megnbenson/flowers/FlowerDesign.stl

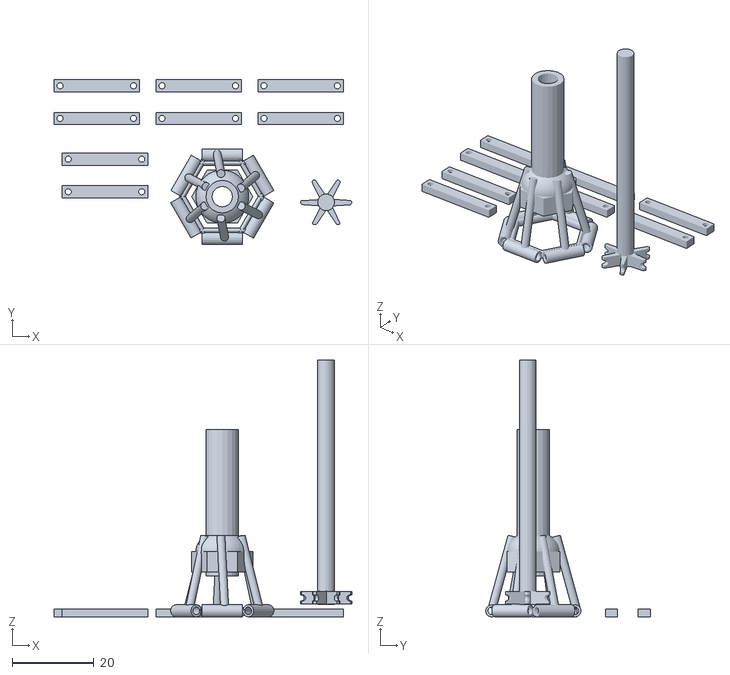
[picture p1: CAD file, 2020-06-19]
FlowerDesign.stl
73.1 x 40.4 x 63.0
