megnbenson/flowers/cogs and teeth.stl

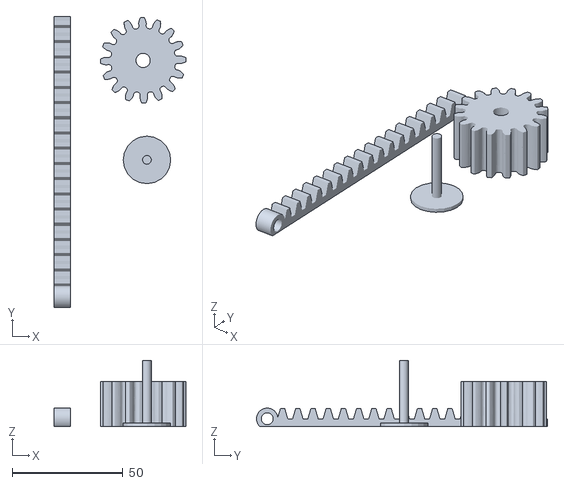
[picture p2: CAD file, 2020-06-19]
cogs and teeth.stl
59.5 x 131.4 x 29.9
