megnbenson/flowers/Ever-Blooming-Mechanical-TulipInstructablesStartingPoint.pdf

instructables

Ever Blooming Mechanical Tulip (http://www.instructables.com/id/Ever-Blooming-Mechanical-Tulip/)

by jiripraus (http://www.instructables.com/member/jiripraus/)

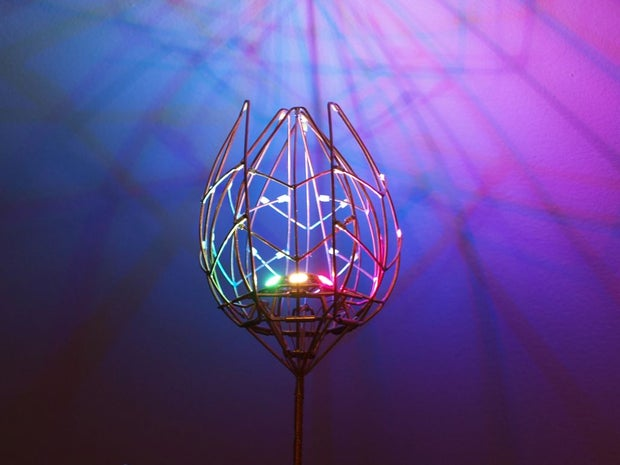
[picture p3: figure]

### Step 1: Watch the Video!

Everlasting

ower for your everlasting love. A perfect not-only Valentine's day gift to your loved one. This mechanical tulip will bloom into any color possible with just gentle touch of your hand. Its six petals will slowly open and light up. When petals are closed they create incredible ambient light with leaf patterns.

https://www.youtube.com/embed/NvRck1Xt7Oc?feature=oembed

Ever Blooming Mechanical Tulip: Page 1

### Step 2: How Does It Work?

I did not record the original tulip on the camera. But I've designed a bit simpli/ed version and shoot a nice video of making these. The concept is the same. You will get an idea of how it works and how it is built.

href="https://www.youtube.com/watch?v=5KxzI7kZFfo">Watch!

Join the community (https://www.facebook.com/groups/210332863382496/) to get in touch with fellow

makers to share ideas, experience and improve the design!

Visit everblooming

ower.com (https://everbloomingflower.com) if you want to have one!

https://www.youtube.com/watch?v=5KxzI7kZFfo

But before I will tell you how to create this beauty, let's talk brie

y about how it works. Tulip consists of 6 petals each with 5 SMD white LEDs. Each petal is connected with one of the Arduino output pins. Blossom hides 7 NeoPixel RGB LEDs. From an electrical point of view, the whole

ower is ground and veins in petals are a positive voltage. Petals are opened by a pushrod which is going all the way down the stem to the base. The pushrod is controlled by a movement of a small hobby servo. Small leaf on the side of the stem is connected to TTP223 touch sensor inside the base and creates a capacitive touchpad. The wooden base contains a servo motor, touch IC and Arduino Nano. Let's build one yourself!

Wha t a re yo u go nna ne ed?
1mm brass rod
2mm brass tubing with 1, 2mm hole 0.3mm copper wire with insulation Some wood for pedestal
Arduino Nano
TTP223 touch sensor
Small servo

Wha t yo u ne ed t o know be f o re yo u s t a rt
How to solder brass (great article) (https://davidneat.wordpress.com/2015/05/03/a-quick-guide-to-soldering-brass/amp/) How to build with Arduino
How to use servos
How to use LEDs and NeoPixels

I am not telling you any dimensions of the components and exact shape of the blossom. I think every

ower should
be a unique one.

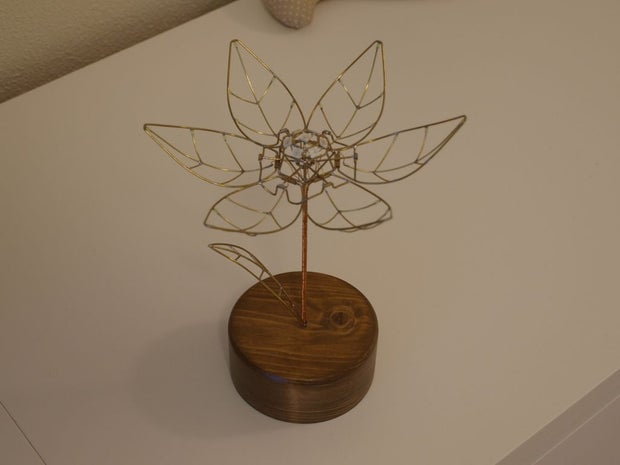
[picture p4: figure]

### Step 3: The Petals (4h)

Let's start with the most satisfying part /rst - petals of the blossom. Note that number in the brackets is a time required to do the step.

The /rst thing you need is a template for the blossom. I created mine from plaster poured into tube mold. When it dried I shaped it into a tulip blossom. You can 3D print it as well but I don't have a 3D printer. The plaster is great because it is easy to machine and a pencil can draw on it. Single petal is 1/4 of the surface of the template so at the end when there are gonna be 6 of them, they will slightly overlap each other creating exact look of a tulip blossom. I draw the petal shape on the surface of the plaster with a pencil. When I was satis/ed with the petal shape I carved it into the plaster with a knife to help me hold rods in place while soldering.

Petal consists of 1mm brass rod going all the way

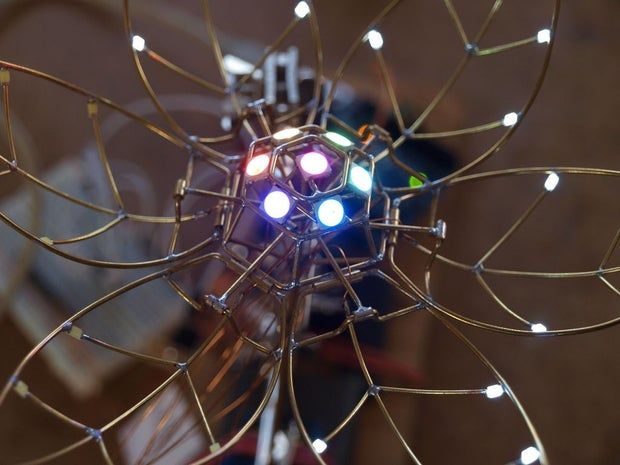
[picture p5: figure]

around the shape. Inside the petal are 5 SMD 1206 white LEDs and a "vein" structure from the very same wire. First, create the circumferential wire, take your time bending it. Cut a small piece of tubing and pass it on the bottom

at part of the wire - this will be the hinge petal will move around. Solder ends of the wire together, make sure you don't /ll the tubing with solder. It needs to move freely. Finish the petal with LEDs and venous structure. Watch me making a single petal. Shame on me, this is the only footage I have from making the

ower.

Now make 5 more of these. All pet als need to be exactly the same. It's really crucial. Otherwise, they would not resemble a nice even tulip shape at the end when closed and may even get stuck.

https://www.youtube.com/embed/GoVWk30cFtE

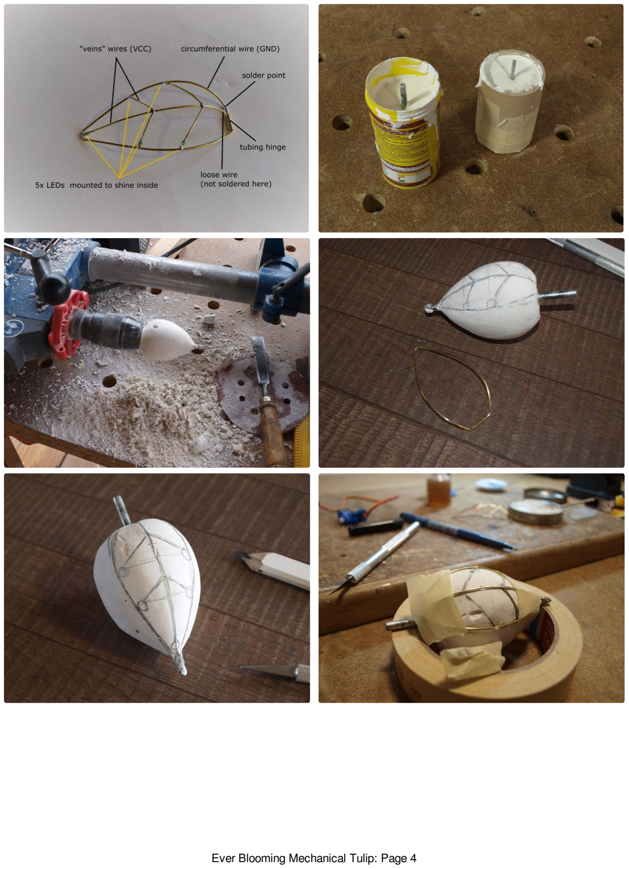
[picture p6: page 4]

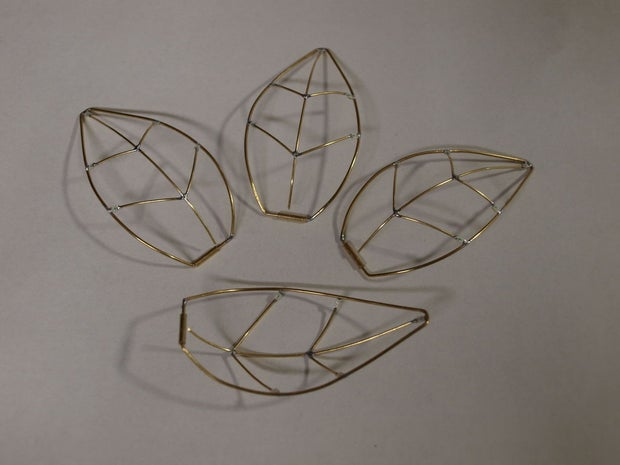
[picture p7: figure]

### Step 4: Blossom (1h)

So far so good? It's time to solder all the petals together. The base of the blossom is hexagonal - 6 petals. Petals are /xed to the hexagon via hinges. The hexagon, however, is slightly irregular. I failed with a regular one. Petals need to overlap each other and if the hexagon is regular they are not allowed to. Three petals are closer to the center (inner petals) and other 3 in slight oKset (outer petals). For that, I created a template and printed it on a paper. The red shape is

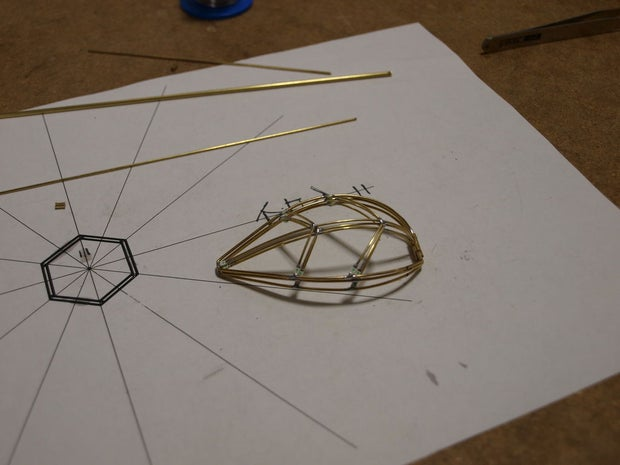
[picture p8: figure]

the /nal irregular hexagon made out of two nested regular hexagons. Solder all the hinges (tubings) to the hexagon. Rays coming out of the center of the template will help you to solder the petals in a correct position. The center of the petal needs to follow the ray line coming out of the center of the hexagon. At the end when you close the petals you will have the /nal shape of the blossom. Nice isn't it?

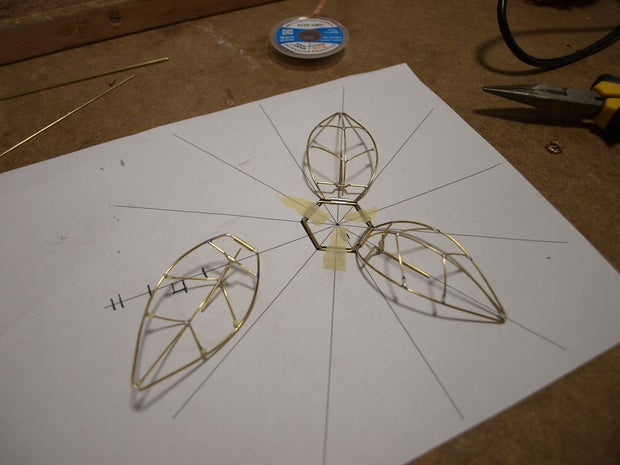
[picture p9: figure]
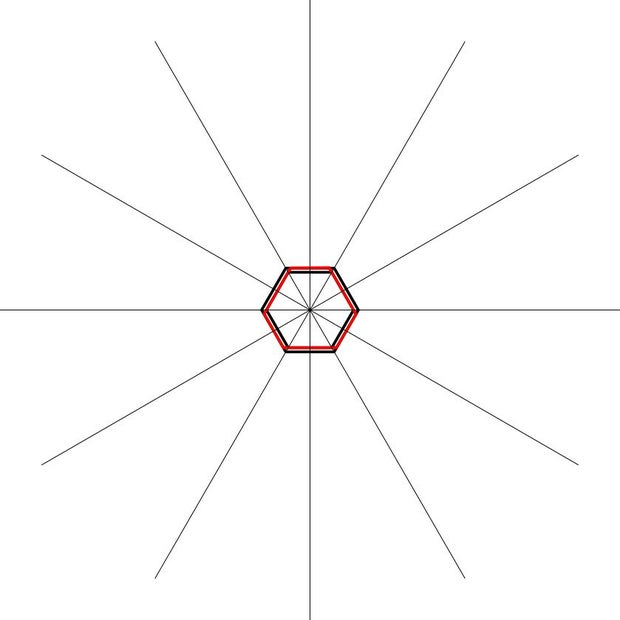
[picture p10: figure]

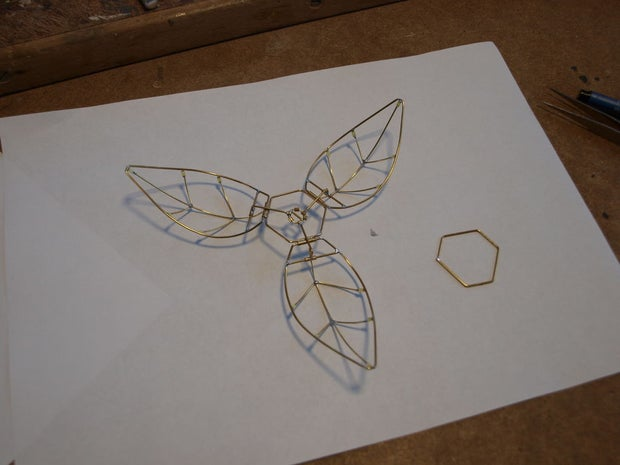
[picture p11: figure]

### Step 5: Creating the Stem and Pushrod (1h)

This is not how I proceed in my making of the

ower. I
/rst /nished the mechanism inside the blossom and then added a stem and pushrod to it. It added a lot of misery into the making. Once I almost wanted to trash it and never look back. Next time I will /rst start with the stem. So you should as well.

Movement of the petals is created by a 1mm brass pushrod freely moving inside a brass tubing. Petals are connected to the pushrod through a really tiny hexagon with small 2mm long hinges on each side -pushrod head. Hexagon is sitting perpendicularly on the pushrod with a help of small bar running through the center of the hexagon. This is watchmaker's job.

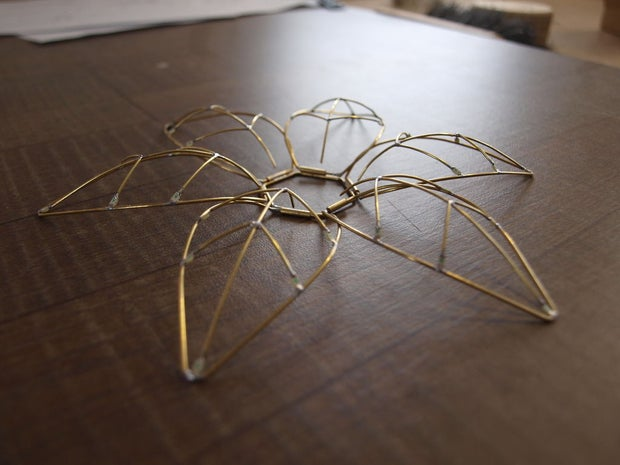
[picture p12: figure]

To create the pushrod head I created the second template. First, bend the wire to form the tiny hexagon. Then cut small 2mm long tubings and pass them on the wire. Solder the wire to /nish the hexagonal shape. Again make sure you do not solder the tubing to the wire. Continue by soldering wire into the center of the hexagon. And /nish the rod by soldering a 1mm wire perpendicular to the center of the pushrod head. Hurray! You have your pushrod.

Build the stem. Cut brass tubing to the desired length. And now the second crucial part. The stem needs to be perfectly perpendicular to the hexagonal base of blossom, needs to be in the exact center of it

and there needs to be enough room for the pushrod head to move down to close the petals. First, I soldered two wires to one end of the stem to create a V-shaped expansion. These will be the 2 out of 6 wires connecting stem to the vertices of hexagonal base.

So

ip the blossom upside down and solder the V-shaped expansion to the 2 opposite vertices of the hexagonal base. Check the shape. If you put a rod inside the stem it needs to come out in the center of the blossom. Take your time here making it perfect. It's really a crucial part. When you are /ne with it, solder 4 more wires between the rest of the hexagon's vertices and the top of the stem. Make sure not to solder the hole inside the tubing!

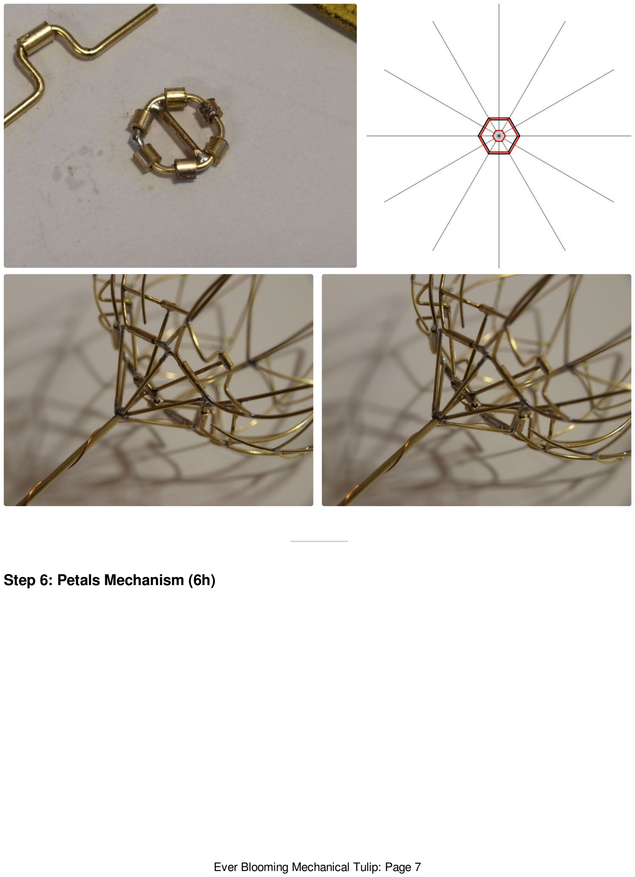
[picture p13: page 7]

### Step 6: Petals Mechanism (6h)

This is the part you gonna regret you ever started making the

ower in the /rst place. I almost throw it into the trash once. But hey, I am not the most patient guy ever. You are gonna nail it! For this part, I've got inspired by steam engines and their rods, pistons, and ywheels.

Make yourself a test stand. Fix the

ower with the
stem in an upward position. Put the pushrod through the stem with its head upward. Solder short tubing perpendicular to the bottom end of the pushrod and create yourself a small connecting rod out of 1mm brass wire to connect servo and the pushrod (see the picture above). You should be able to move with pushrod up and down using a servo. Try it by hooking up your Arduino. Before you can start soldering the connecting rods between petals and pushrod head you need to tune up the servo movement with Arduino. Write your code to move pushrod up and down in a way when in the topmost position the pushrod head end is

ush with blossom hexagonal base. And in the lowest position, it sits on the bottom of the blossom V-shaped base.

Tip: Use Adafruit_TiCoServo (https://github.com/adafruit/Adafruit_TiCoServo) library to control the servo. Itwill allow you later to control NeoPixels atthe same time asthe servo.

Tip: To make your pushrod movementis assoft as possible, use the hole closestto the center of the servo arm. The servo will need to spin longer butwith shorter steps.

Petals are currently missing one crucial part - petal pin. This hinge makes the petals move. The hinge sits on a bar (see image above) which is soldered to each petal parallel to its base. Petal pin needs to be above the surface of the petal in order to allow it to fully open as you can see on the animation. Make yourself one such bar with a hinge from tubing and solder it to the /rst petal. This will need a lot of experimenting with the size of the bar and its distance from the petal base to allow the pushrod to fully open and close the petal. Use trial and error method. Solder the bar to a suitable position and add connecting rod between the pushrod pin and the petal pin. If you have your pushrod in the upper position and your petal in a fully opened position, space between pushrod pin and petal pin is the length of the connecting rod.

Now try to move with pushrod up and down to see what is happening. If it works /ne without any rubbing and petal can be closed and opened you are done (with the /rst petal)! If not, try a diKerent length of connecting rod or diKerent position of the bar. In order to /nish the blossom, duplicate the same bar and connecting rod on each of the 5 remaining petals. The 3 outer petals need to be a little lower when the blossom is opened to allow them to properly overlap the inner petals while closing. In the end, you should be able to close and open the blossom. Don't panic if you failed to do the perfect shape for the /rst try. It only means all the petals are not perfectly the same. It will probably take a lot of /ne-tuning to create a perfect shape - slightly diKerent lengths of connecting rods and positions of bars. Take your time here! A reward is near.

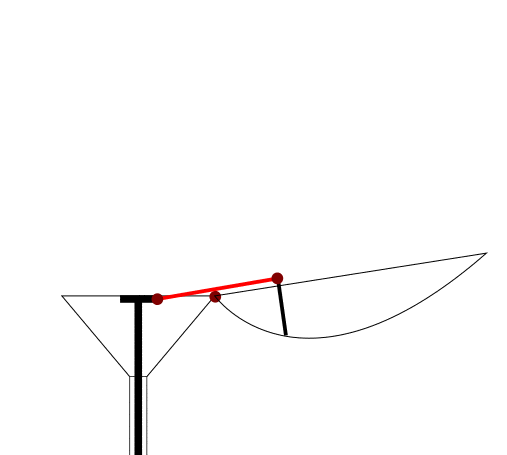
[picture p14: figure]

https://www.youtube.com/embed/_hzQIuPzaBM

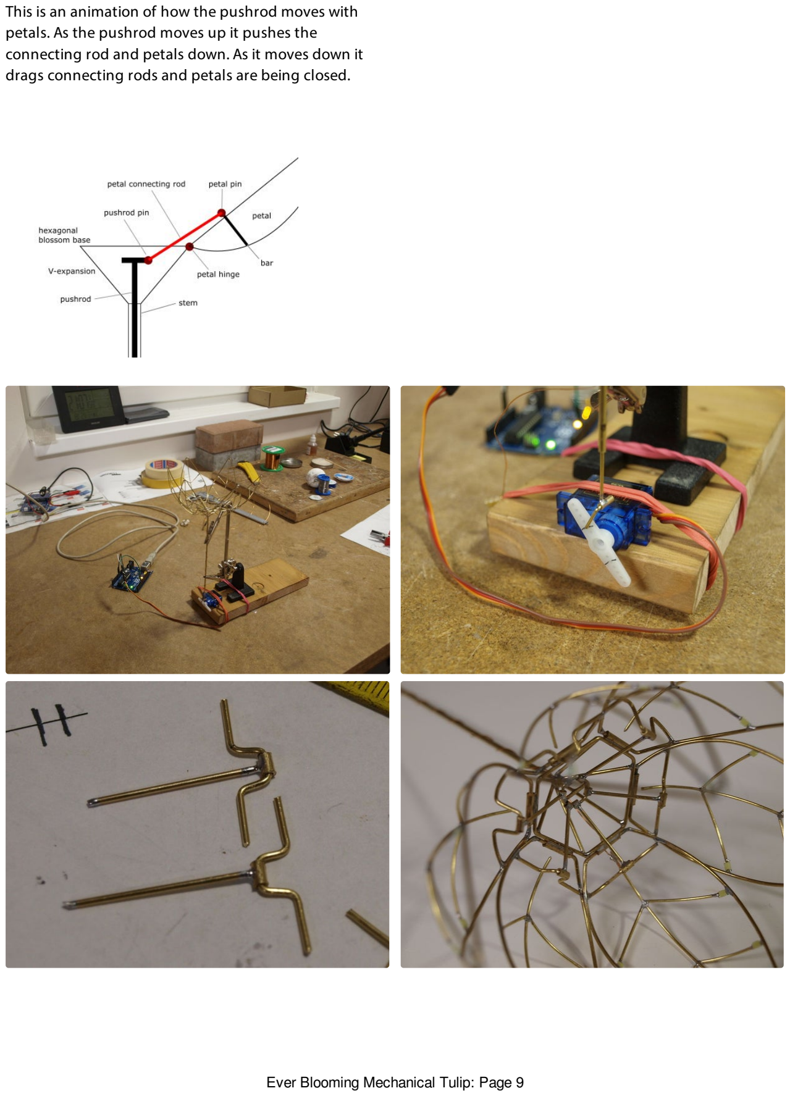
[picture p15: page 9]

This is an animation of how the pushrod moves with petals. As the pushrod moves up it pushes the connecting rod and petals down. As it moves down it drags connecting rods and petals are being closed.

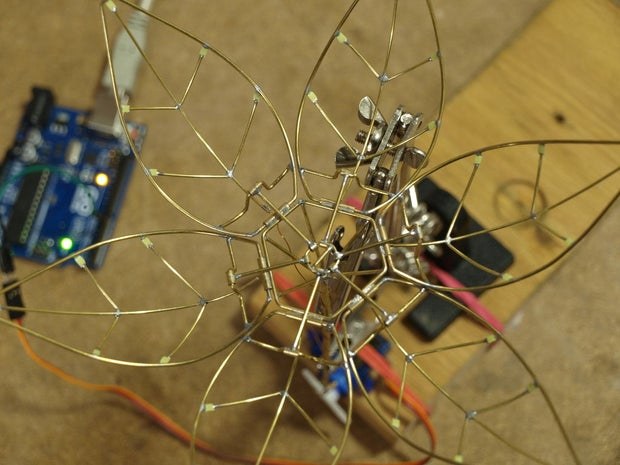
[picture p16: figure]

### Step 7: Rainbow Pistil (1h)

If you made it to this step you are a king and the hardest parts are behind you. Inside the blossom, I put 7 NeoPixels LEDs to shine from inside. These LEDs need only one DATA wire to be controlled and can be daisy chained. I soldered 6 of these between two small hexagons (another template of course). Lower hexagon is a ground wire and the upper one is a positive voltage. Solder appropriate leads of NeoPixels to these hexagon rings. These LEDs are placed under the 45-degree angle to shine into sides. To make it even better place the seventh LED into the center of the upper hexagon. Last but not least connect DATA IN and OUT leads to create a daisy chain.

This structure will need two wires going down to the pedestal - VCC and DATA. The ground is taken from the

ower frame. Solder one thin 0.3 insulated copper wire to the upper ring for VCC and the second one to the /rst LED in the daisy-chain for DATA. These wires will at the end go down to the pedestal. Make them at least 3 times the length of the stem. Ends of these wires need to be released from their transparent insulation prior to soldering. Heat won't destroy it. Use a knife to strip oK the insulation. You can test the LEDs now to make sure they work. Be gentle with these copper wires. If you accidentally strip the insulation anywhere else than ends, you might get a short circuit!

Last brass soldering work is now going to happen! Place the pistil structure to the center of the blossom. Slightly oKset it from the blossom hexagonal base to leave enough room for petals connecting rods. For me, it was 1cm above the blossom hexagon. Connect all the vertices with brass rods to make a solid structure. The

ower is done! Test it now to see if petals can still move freely.

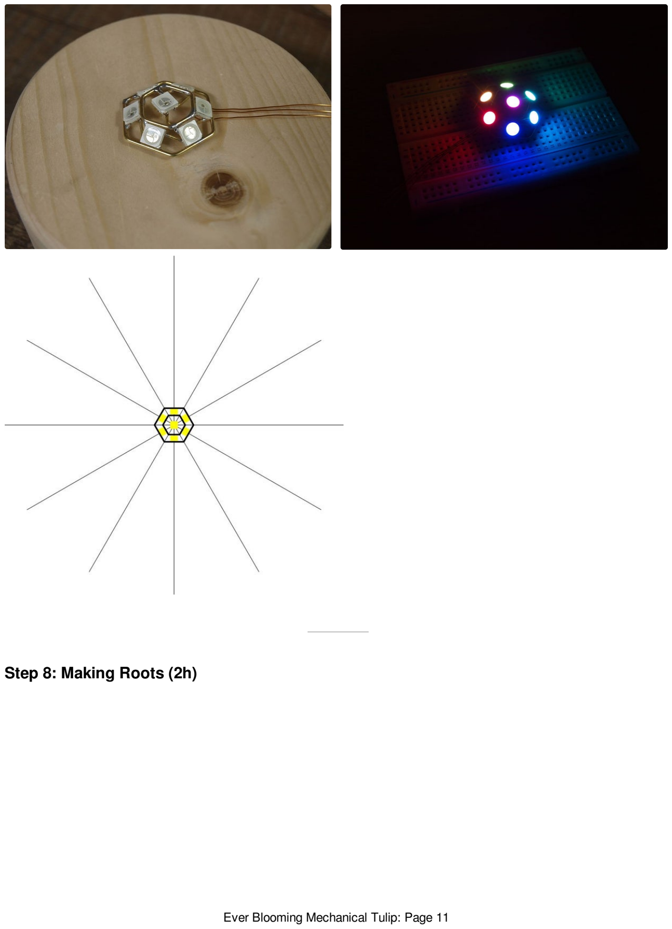
[picture p17: page 11]

### Step 8: Making Roots (2h)

Both petals and NeoPixel LEDs need power wires to shine. The whole

ower sculpture will be a ground but there are 6 petals and 2 wires for NeoPixels that need to be connected to Arduino in the pedestal. For that, thin 0.3mm copper wires with transparent insulations will be wrapped around the stem tubing. Two wires for Neopixels are already done. Solder another 6 to the loose vein wire on each petal near the hinge and pass the wire through the blossom structure down the stem. Make sure you don't bend these wires in sharp angles, it would break soon.

Now gather all the wires near the upper end of the stem tubing and secure them using strapping tape. Don't tighten it too much yet, allow wires to be pulled through it. Now nicely organize all the wires inside the blossom. Make sure petals are free to move and the pushrod is not colliding with the wires as well. Done?

Now tighten the strapping tape.

Wires are now

ying around the stem uncontrollably. You need to patiently and slowly wrap them down the stem. Tightly and evenly. It took me at least an hour to /nish this step. When you are at the end of the stem, place another strapping tape to secure the wires there and use clear superglue to /x them in the place. Make sure not to seal the tubing with the pushrod!

Last wire missing is a ground. Solder another copper wire to the bottom end of the stem. You should end up with 9 wires coming out of the

ower. It'd wise
now to connect all the wires to Arduino and test whether there is no short circuit and all the LEDs light up.

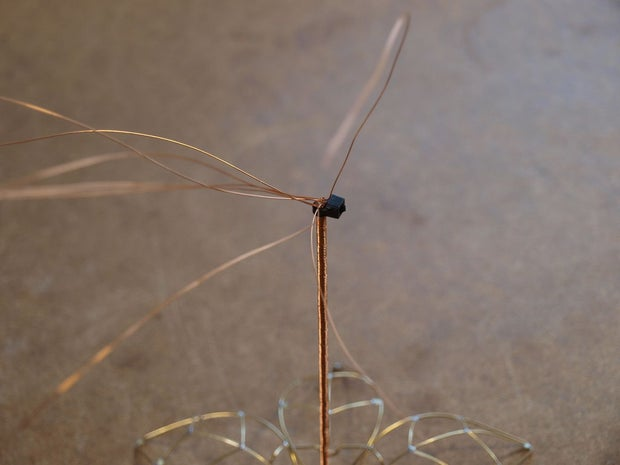
[picture p18: figure]
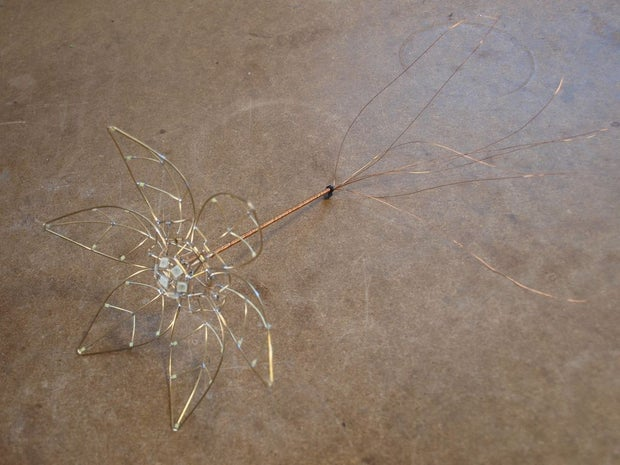
[picture p19: figure]
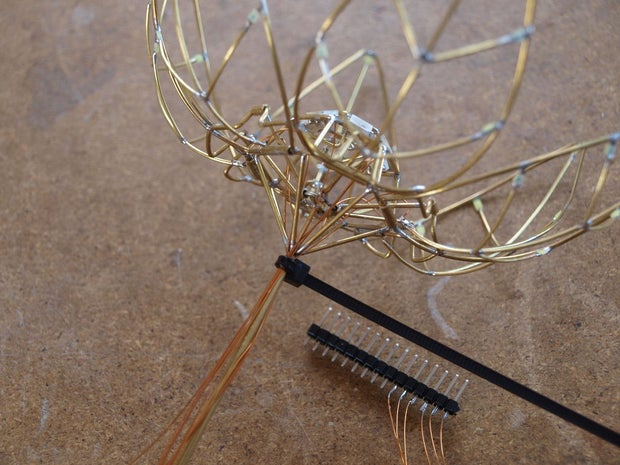
[picture p20: figure]
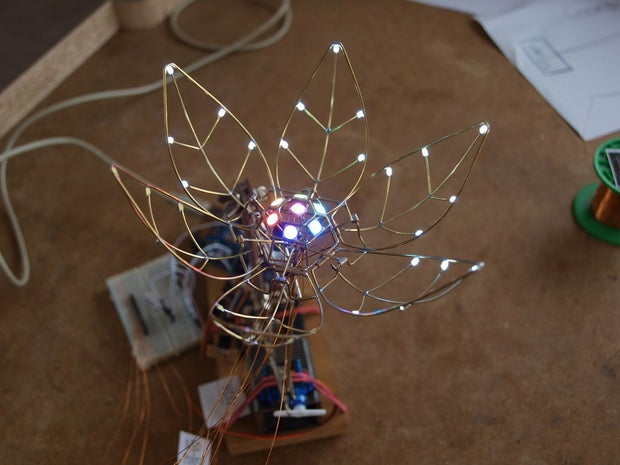
[picture p21: figure]

### Step 9: The Flowerpot (2h)

I wanted the

ower to grow out of the arti/cial owerpot which would also hide all the electronics. I've used a piece of wood and processed it into a cylinder 4cm high and 9cm in diameter. I don't have a lathe, so I used a circular saw to cut raw shape and then a press drill to act as an improvised lathe. Then I carved an opening 2.5cm deep and 7cm in diameter using hand milling cutter to /t servo, Arduino Nano and the touch sensor IC. On the bottom side of the cylinder, there is also a small opening to precisely /t Arduino Nano USB port to be able to connect the USB cable from the side.

If you have your

owerpot, drill a hole in diameter of your

ower stem with wires in a place where the ower will grow - probably in the center. Try to /t your ower. Be careful with the wires . If you bend them under a sharp angle, they will break. In the end, I've also added a large hole from the inside of the pedestal to make more room for servo's arm and connecting rod.

You can do whatever shape of

owerpot you like, just
keep in mind you need to /t all the electronics inside.

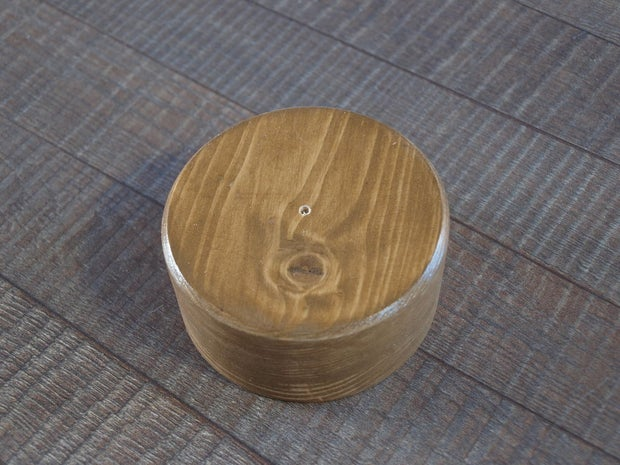
[picture p22: figure]
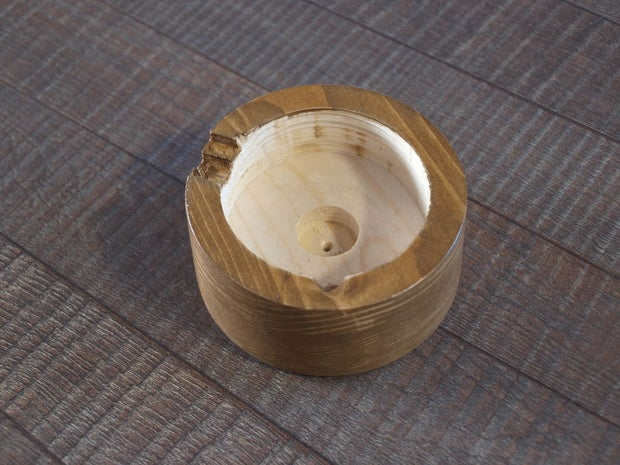
[picture p23: figure]
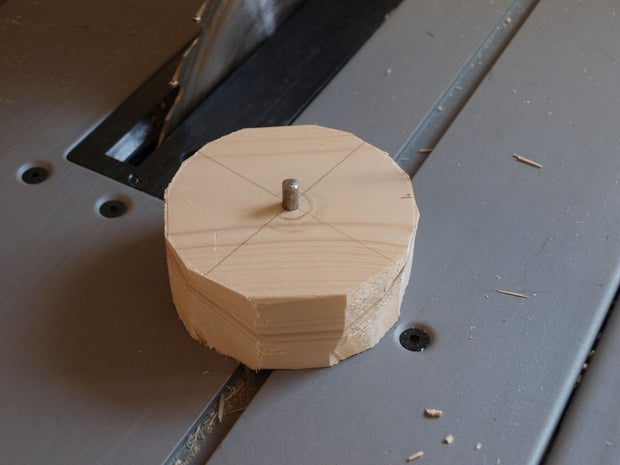
[picture p24: figure]
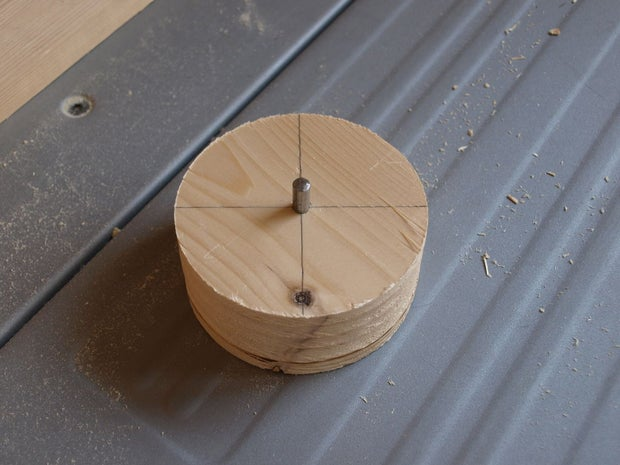
[picture p25: figure]

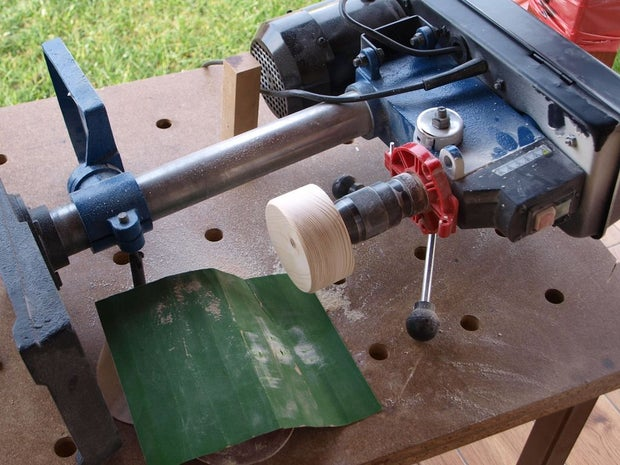
[picture p26: figure]

### Step 10: Touch Leaf-pad (1h)

### Step 11: Putting It Together (2h)

Mechanical tulip needs some kind of interactive element that would allow the person to make it bloom. I've chosen TTP223 touch sensor IC from my Arduino

ake project. (https://www.tindie.com/products/jiripraus/arduinoflake/) But where to put a touchpad? I've decided to add a little leaf on the side of the stem that would both make the

ower more natural and
also will act as a capacitive touchpad. When touched it would trigger the TTP223 sensor and tell Arduino to open the blossom. This will be piece of cake for you now when you have /nished such a complicated

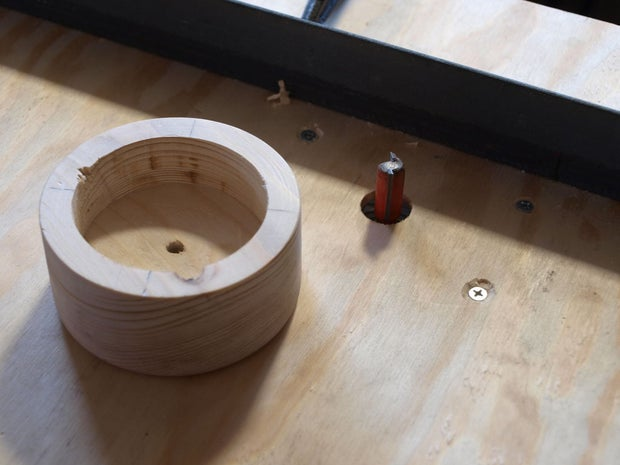
[picture p27: figure]

sculpture. Use the same technique as for the petals just omit the LEDs. I've also created a template for myself. Drill another small hole into the pedestal next to the stem hole to hold the leaf in the place.

If you don't want or can't use a capacitive touch sensor you can add a normal push button to the pedestal. It will do the same job.

This is the /nal step of the assembly! Are you nervous? Insert your

ower stem into its hole in the pedestal again. Now, this is an important step. Measure twice before you cut! Open the blossom into its full opening. And cut the end of the pushrod coming out of the stem

ush with the stem. Now when you close the blossom again, pushrod should draw out of the stem. Solder a short tubing perpendicularly to the pushrod. This will be a hinge for the connecting rod with the servo arm. When you let go the blossom and the rod, it should stop full open because the tubing will act as a stop as well.

You can now glue the stem into the pedestal. Make sure stem tubing end is

ush with the inside of the pedestal to leave as much space for servo arm as possible. I've used superglue again. Make sure you don't glue the pushrod with the stem tubing. It would ruin your work!

Next, glue in the leaf-pad. Before you do solder a copper wire to it to be able to connect the leaf-pad to TTP223 touch sensor.

Put

ower upside down. Be careful around the sculpture, do not break it right now! It would be so much waste! First, put the servo into /nal position. Its arm should be already prepared from the test stand. Just /nd the sweet spot where servo arm would move freely inside the pedestal and connect connecting rod to the pushrod. To secure the servo in place I used a piece of sheet metal and two screws. I wanted to be

exible here in case of servo breakdown or a wrong placement. But if you are con/dent you can glue it in.

If you have TTP223 module, solder the wire to leaf-pad on the original TTP223 module's touchpad (opposite side where the components are). You will need to scratch down the protective silk mask to expose the copper layer. Glue the touch module in.

Petal leafs wires (there are 6 of them) has to be connected to Arduino via current limiting resistors. Petals are basically LEDs. I've used six 200ohm resistors soldered on a tiny piece of perf board. Glue it in.

And the last component into the pedestal is Arduino Nano itself as a brain of the mechanical tulip. Place it into the opening in pedestal so it can be connected to your computer and wire it with all other components:

servo data wire D9 (required for Adafruit_TiCoServo library) TTP223 touch sensor data D2 (to make use of interrupt) Neopixel data A0 (any output pin will do)
Petals D3, D4, D5, D6, D10, D11 (any output pins will do) Flower ground wire GND
Neopixel VCC wire 5V

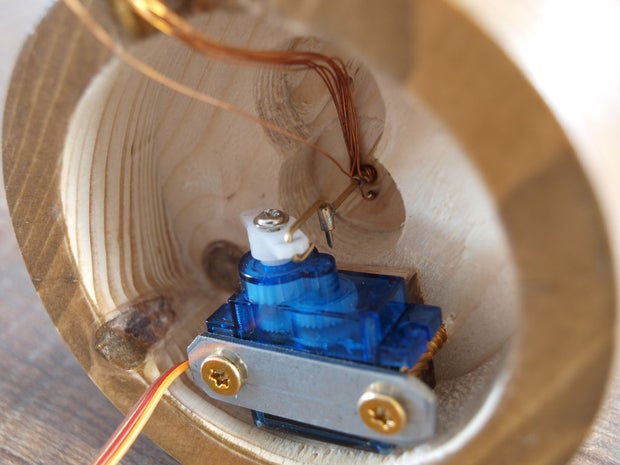
[picture p28: figure]
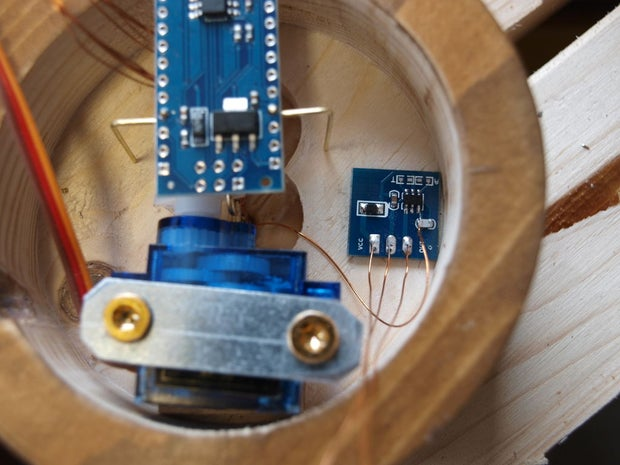
[picture p29: figure]

TTP223 touch sensor GND GND
TTP223 touch sensor VCC 5V Servo GND GND
Servo VCC 5V

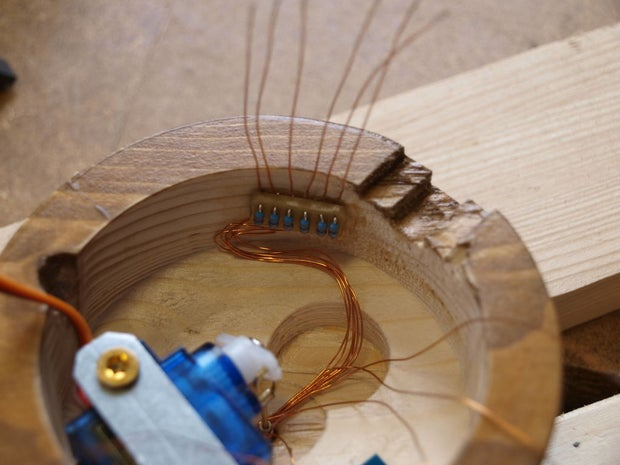
[picture p30: figure]

### Step 12: Coding (1h)

### Step 13: It's Done!

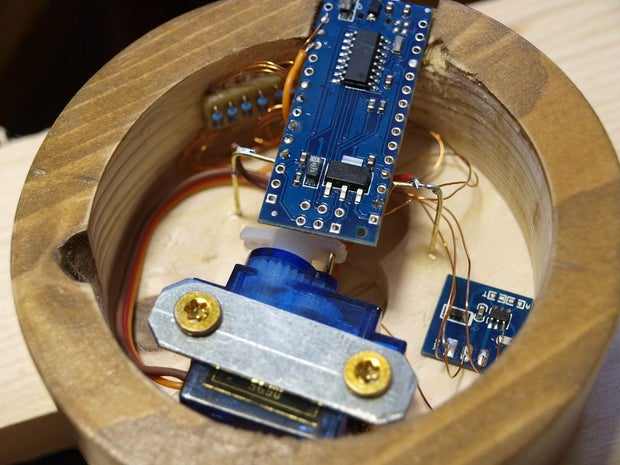
[picture p31: figure]

Programming is the easiest part of all. You already have your code for the servo. Now you only need to be able to control NeoPixels, LEDs on petals and the touch sensor. Take a look into my code attached. It will give you everything you need to make your

ower work. If you used my wiring scheme, you can use it right away. But don't forget to change the servo OPEN and CLOSED values. They will be de/nitely diKerent.

https://www.instructabl…

Download (https://cdn.instructables.com/ORIG/FYL/3MN4/JSCG3L7L/FYL3MN4JSCG3L7L.ino)

Visit everblooming

ower.com (https://everbloomingflower.com) if you want to have one!

Join the community (https://www.facebook.com/groups/210332863382496/) to get in touch with fellow makers to share ideas, experience and improve the design!

Don't forget to share your creations! Like this article. Also, consider supporting me on Patreon. (https://www.patreon.com/jiripraus)

I am Jiri Praus.

Instagram, (https://www.instagram.com/jiripraus/) Twitter, (https://twitter.com/jipraus) YouTube (https://www.youtube.com/channel/UCc6AdKjYOjNTsvr0Ichf0EA)

www.jiripraus.cz

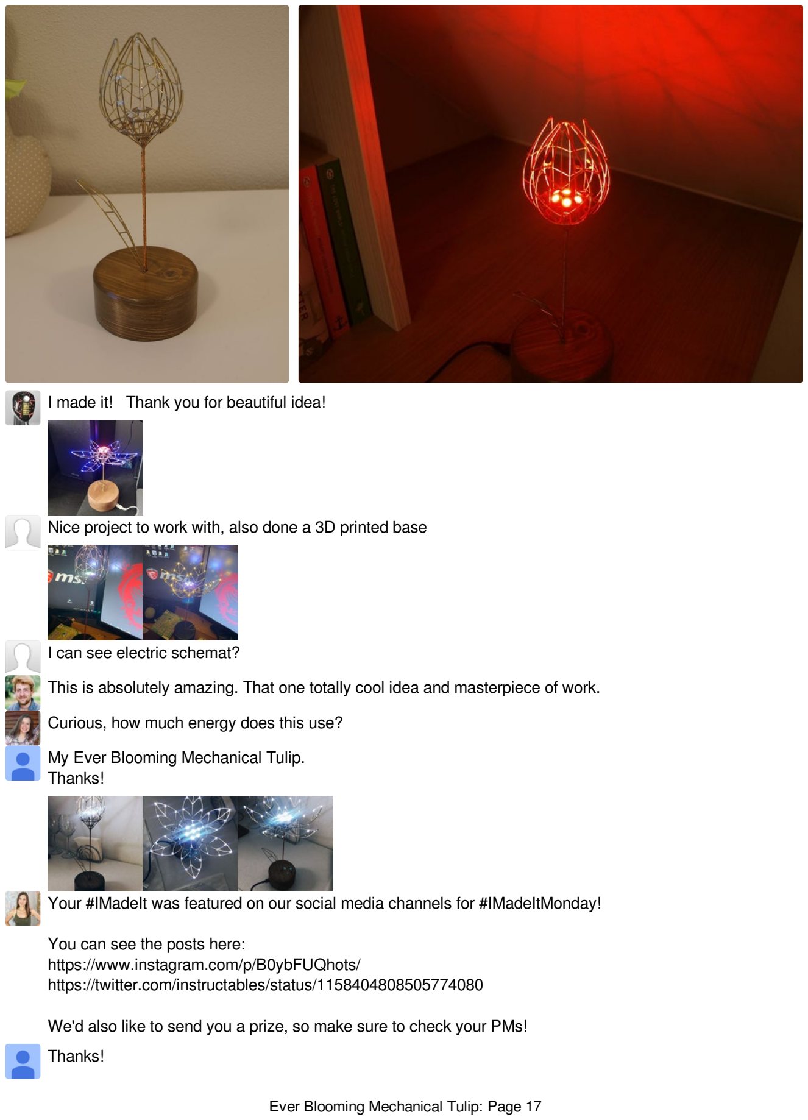
[picture p32: page 17]

I made it! Thank you for beautiful idea!

Nice project to work with, also done a 3D printed base

I can see electric schemat?
This is absolutely amazing. That one totally cool idea and masterpiece of work. Curious, how much energy does this use?
My Ever Blooming Mechanical Tulip.
Thanks!

Your #IMadeIt was featured on our social media channels for #IMadeItMonday!

You can see the posts here:
https://www.instagram.com/p/B0ybFUQhots/https://twitter.com/instructables/status/1158404808505774080

We'd also like to send you a prize, so make sure to check your PMs! Thanks!

I almost built a similar. Thanks for the idea.

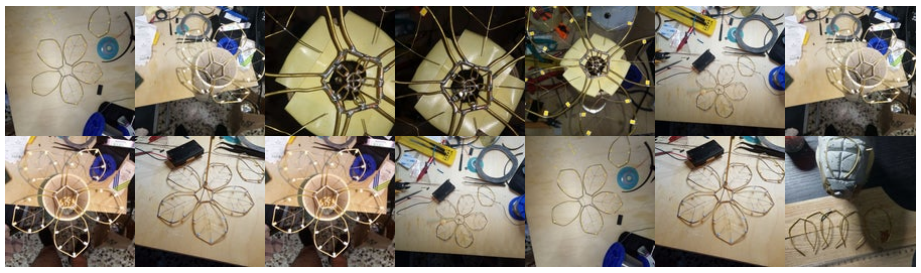
[picture p33: figure]

Some photos on process. Thanks for the idea .

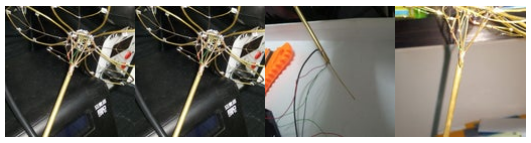
[picture p34: figure]

ITS THE INFINITY GAUNTLET
Thank you so much for posting this instructable. I love the way the flower turned out when I made it. I added a second capacitive touch sensor to add more features.

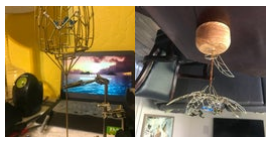
[picture p35: figure]

Increadible work! I am so glad, the intructable is working! My progress so far, still a lot to do...

Awesome! This looks like one of mine!
wow me encanta! que buen trabajo!!!
Super! i was very impressed, when saw it first time) now i made the same) Thanks!!!!!

I am totally impressed! It looks increadible. Can it move? I would like to use your photo, is it ok? I would like to make collection of derivates :)
yes.it moves almost like original) you may use my photo as you wish,i can add more)

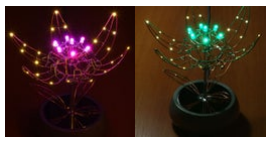
[picture p36: figure]

Increadible work! It's totally awesome. I am glad it is doable :)

Hey bro. This is amazing! But could you tell me at least approximate dimensions and proportions?

Looks awesome. I saw this and it reminded me of a video I saw about flowers and thought with the lights it would look cool. I've seen it done with just nail polish too. Doing something like this, I don't think would hide the mechanics of it either. Just thought I would share.

https://www.facebook.com/buzzfeednifty/videos/1966330553621667/
Nice, I was considering using some kind of paper or cloth to cover the petals. I decided not to, maybe next time :)
Looks beautiful, you are a artist!
Thank you.
Very nice piece. I hope you win the contest. Let me know if you have ones for sale. Peace! Wow this is awesome dude, thanks for your cool project :D
You deserve to be a grand prize winner of epilog x contest hats off to your creativity and putting things together. Simply great.
thanks for this amazing instructable :)
Did you not review the soldering video before posting it? It is totally worthless. You concealed what you were doing. Go back and look at it for yourself.
I am sorry for that, I know. It's not the best. This is my first video ever taken of me soldering something. I need to learn to do it properly. On the other hand this was the only footage I had so I decided to use it anyway.
Amazing, successful amalgam of creativity, art, and technology

Thanks for the result, and thanks for the detailed how-to

I just have to try this
Let me know the result :)
Da vinci of this generation. Awesome work.
Never thought of that, but I love Da Vinci mechanical work :) I'll be looking for more inspiration there!
OMG, this is so amazing! Thanks for sharing! One of the best projects i ever saw!
Thank you!
I want to make it but when I went to download the instructions an error message comes up.
This is happening for me too. The error message says that the download couldn't be found. After logging in and poking the download button I get a page that says "{"error": "Sorry, we couldn't find that one!"}"
This is a known issue that is actively being addressed by the site's engineer team. We're hoping to restore functionality of the download-as-PDF button very soon.
Hi, I will contact the instructables team to see what is happening.
This is so beautiful. I have a question. Does SMD LEDS have polarity?

Yes they have, every LED have polarity. Usually, there is a small arrow on the back of the LED or small dot pointing to the ground.
Yes. The differece is the package, the mechanical mounting platform that the LED die has. By definition a LED has polarity because it's a diode.
It's a really cool project you did - with the petals having LEDs and the capacitance! LOVE how you made the base so compact.

I made something similar to this, but different. My petals were cut up hard drives into six petals, and the "hinges" were tyvex from Fedex envelopes to connect to the push rod in center, that's connected also to a servo. My flower was based on a photoresistor detecting light (open), or dark (close).
Love it! Incredibly intricate and visually stunning. Can't wait to see what you do next!
Very clever. Looks great. At first I thought you used memory wire.
This is beautiful and fascinating! I also really like how you integrated the touch sensor. Mind blowing instructable ..... Simply says WOW ..
Absolutely gorgeous, a piece of jewelry, thanks for sharing !
