megnbenson/flowers/(commit log)

2020-06-19 deleted hugo stuff, added files used for flower creation
    [FlowerDesign.stl, cogs and teeth.stl]
2020-06-19 adding html for flowers
